M-SheheerMasood/kalos-dex/scad/renders/case_back_open.png

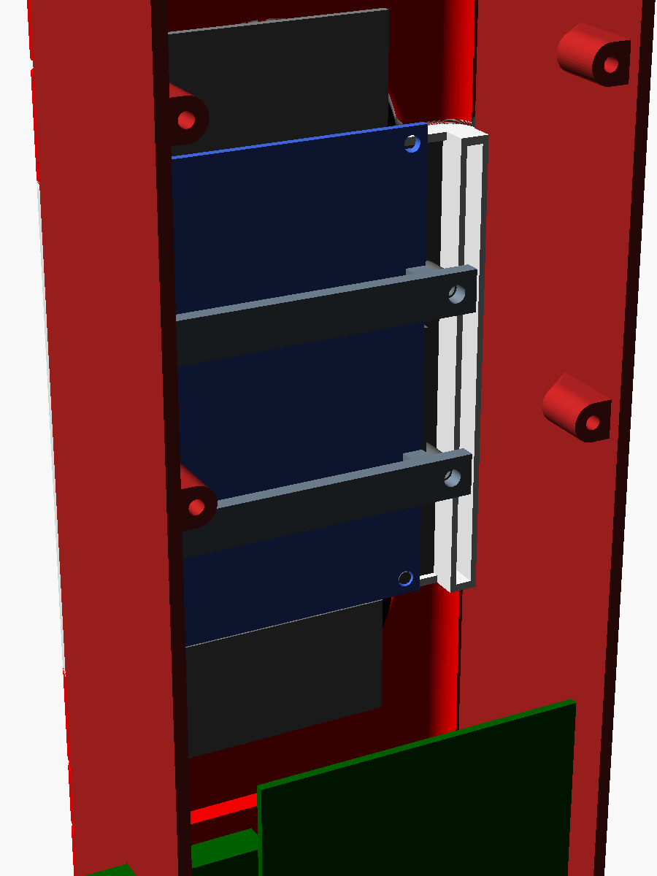
scad/renders/case_back_open.png
