M-SheheerMasood/kalos-dex/scad/renders/case_cutaway.png

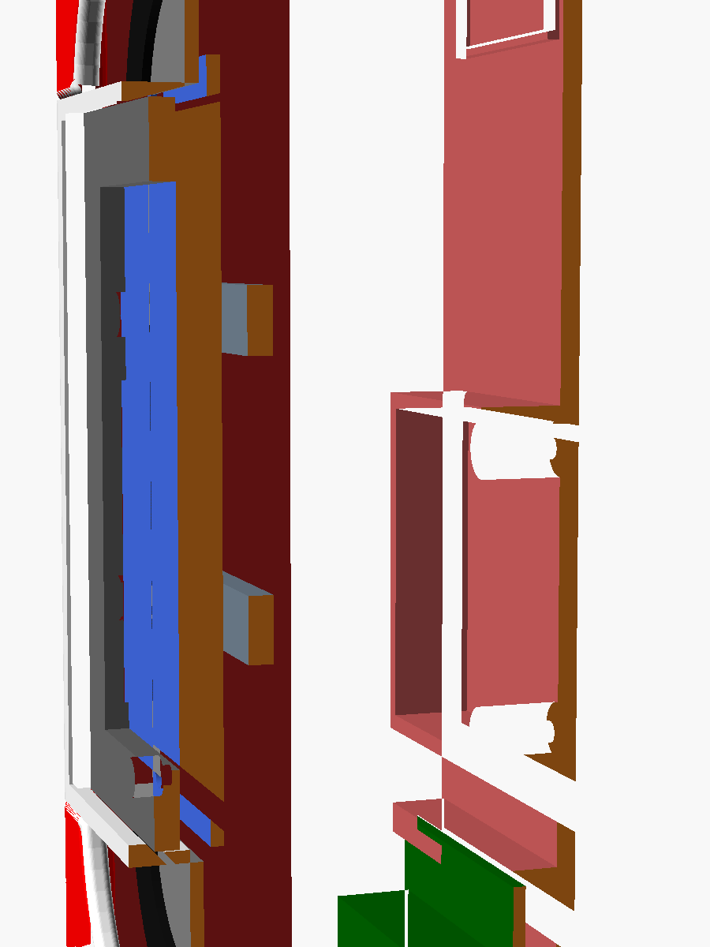
scad/renders/case_cutaway.png
