M-SheheerMasood/kalos-dex/scad/renders/case_front.png

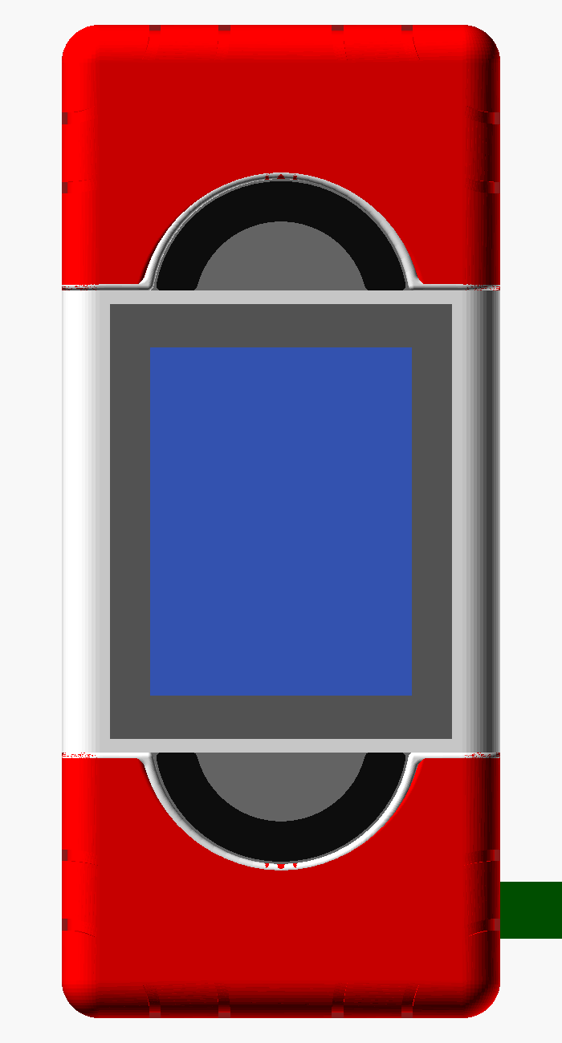
scad/renders/case_front.png
