M-SheheerMasood/kalos-dex/scad/renders/case_front_angle.png

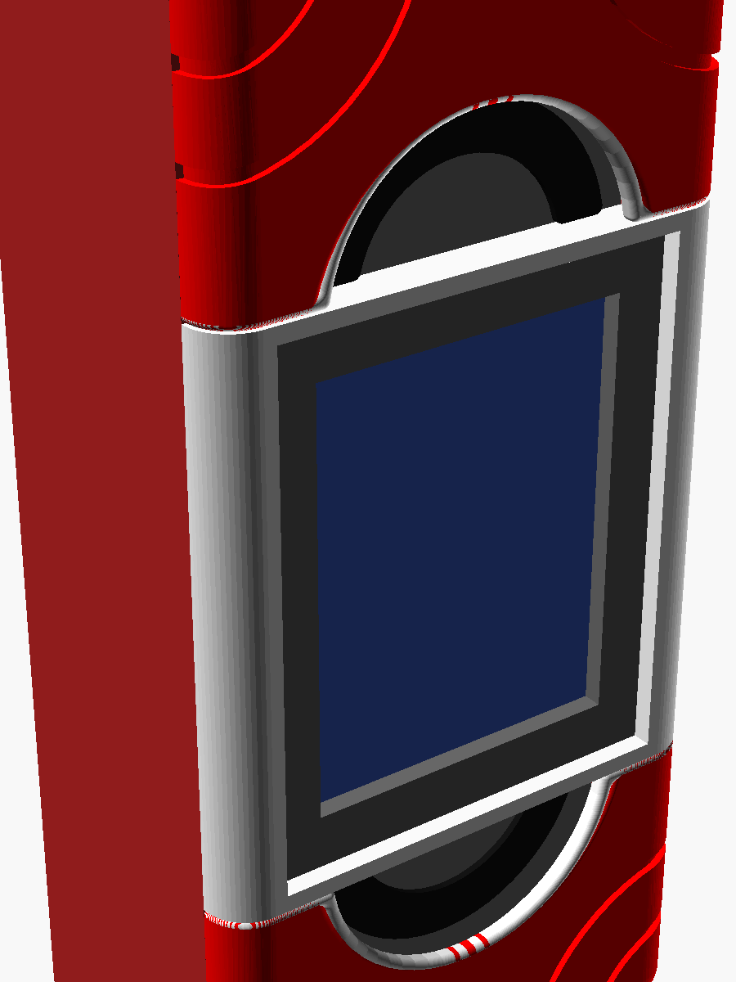
scad/renders/case_front_angle.png
