M-SheheerMasood/kalos-dex/scad/stl/main/any_knob.stl

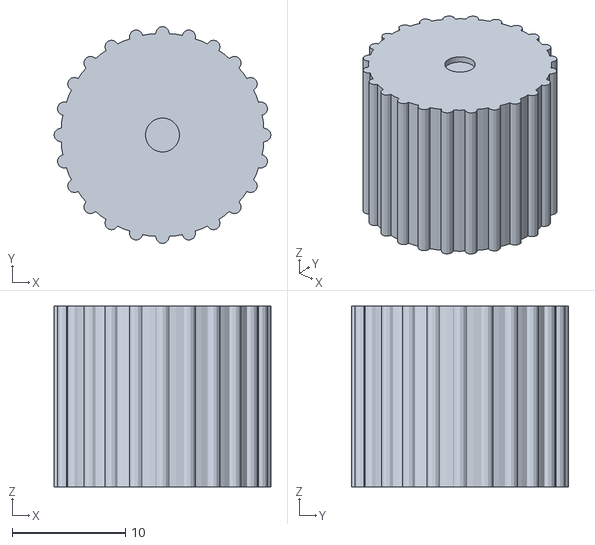
[picture p12: CAD file, 2026-10-22]
scad/stl/main/any_knob.stl
19.2 x 19.2 x 16.0
