M-SheheerMasood/kalos-dex/scad/stl/main/red_back_lid.stl

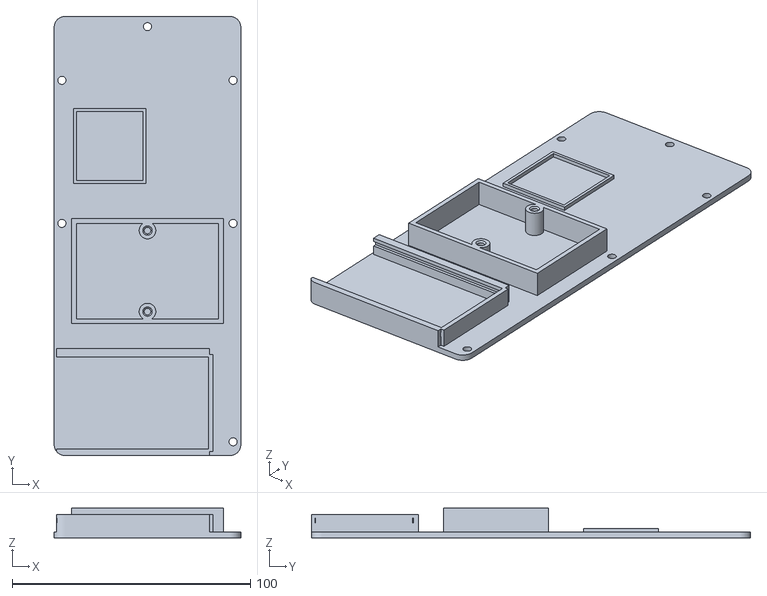
[picture p13: CAD file, 2026-10-22]
scad/stl/main/red_back_lid.stl
78.3 x 184.1 x 12.4
