M-SheheerMasood/kalos-dex/scad/stl/main/any_button_cap_x4.stl

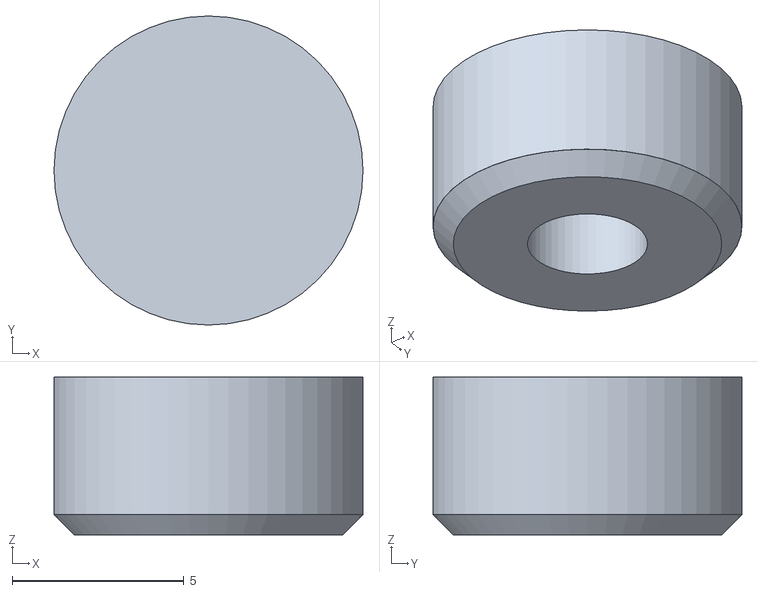
[picture p14: CAD file, 2026-10-22]
scad/stl/main/any_button_cap_x4.stl
9.00 x 9.00 x 4.60
