M-SheheerMasood/kalos-dex/scad/stl/main/white_screen_ring.stl

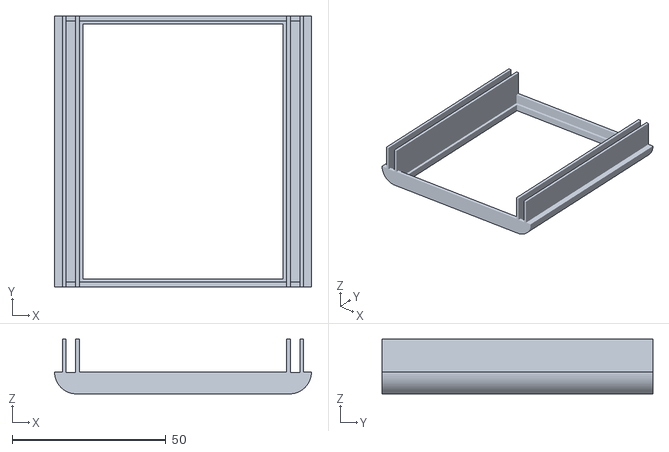
[picture p15: CAD file, 2026-10-22]
scad/stl/main/white_screen_ring.stl
83.6 x 88.0 x 17.9
