M-SheheerMasood/kalos-dex/scad/stl/main/grey_screen_face.stl

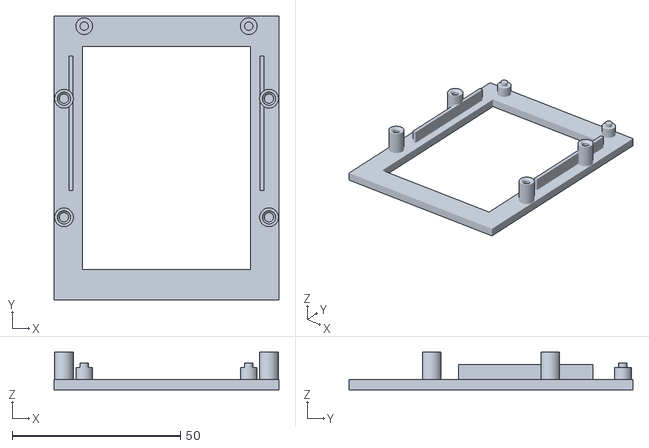
[picture p16: CAD file, 2026-10-22]
scad/stl/main/grey_screen_face.stl
66.9 x 84.5 x 11.2
