M-SheheerMasood/kalos-dex/scad/stl/main/red_tub.stl

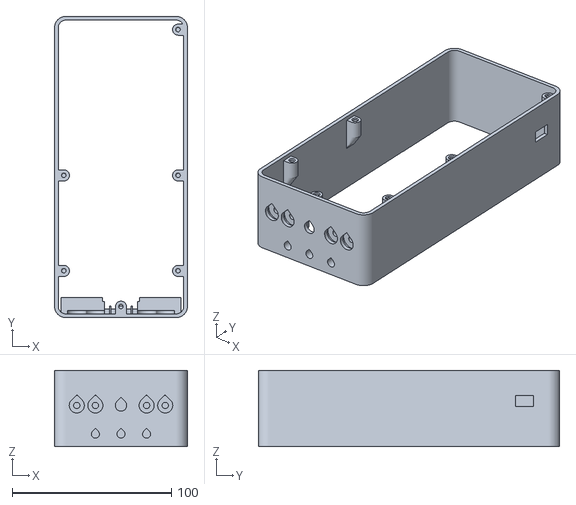
[picture p17: CAD file, 2026-10-22]
scad/stl/main/red_tub.stl
83.6 x 189.4 x 47.9
