M-SheheerMasood/kalos-dex/scad/stl/main/any_switch_retainer_x2.stl

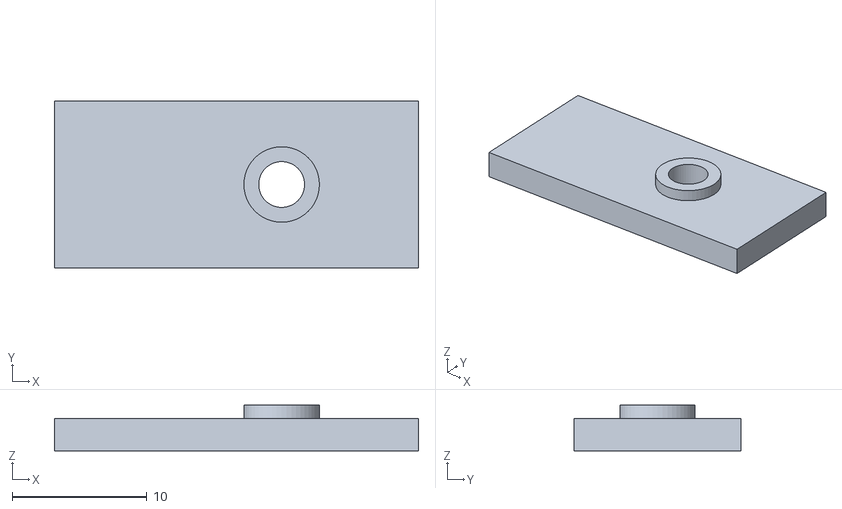
[picture p18: CAD file, 2026-10-22]
scad/stl/main/any_switch_retainer_x2.stl
27.0 x 12.4 x 3.40
