M-SheheerMasood/kalos-dex/scad/stl/main/any_weight_cover.stl

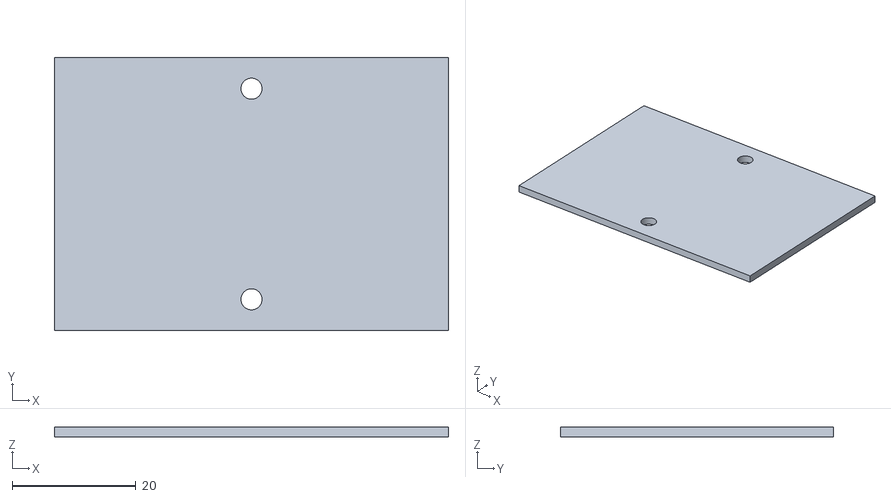
[picture p19: CAD file, 2026-10-22]
scad/stl/main/any_weight_cover.stl
63.6 x 44.0 x 1.60
