M-SheheerMasood/kalos-dex/scad/stl/main/any_display_clamp_x2.stl

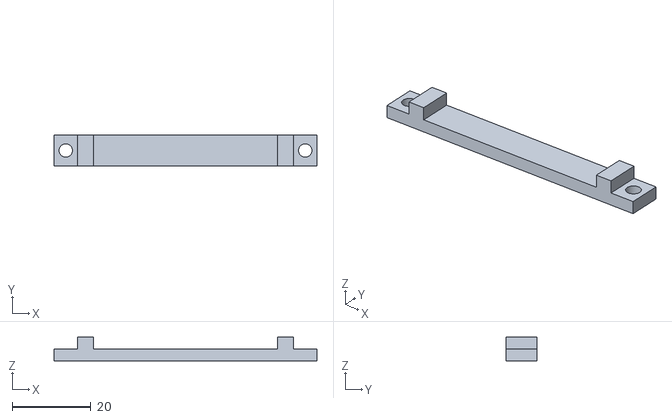
[picture p20: CAD file, 2026-10-22]
scad/stl/main/any_display_clamp_x2.stl
67.0 x 8.00 x 6.00
