M-SheheerMasood/kalos-dex/scad/stl/main/grey_arch_fill_x2.stl

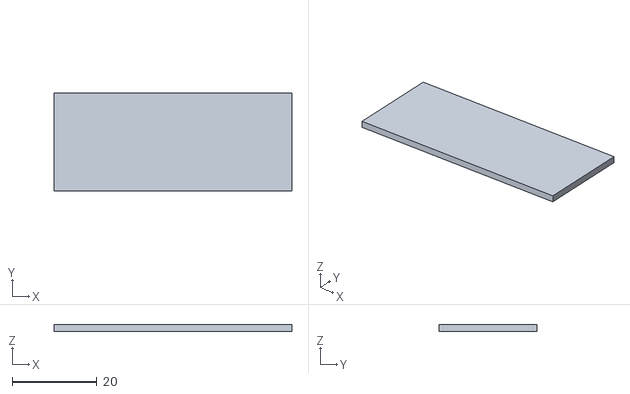
[picture p21: CAD file, 2026-10-22]
scad/stl/main/grey_arch_fill_x2.stl
56.0 x 23.0 x 1.60
