M-SheheerMasood/kalos-dex/firmware/kalos-dex/src/pet.h

// The virtual pet (F6): food / fun / energy (0..100), XP + levels, evolves, sleeps at night, keeps living
// while switched off (capped catch-up from the RTC), never dies. Owns the mood glow + the red status LED.
// Saved with storage's A/B + CRC records: every 3 min and 3 s after each feed / play.
#pragma once
#include <Arduino.h>

namespace pet {
enum class Mood : uint8_t { Egg, Sleeping, Hungry, Tired, Sad, Happy, Okay, Angry };   // add new ones at the end
enum class Result : uint8_t { Ok, Full, TooTired, Egg, Angry };

void begin();                  // after storage + timekeeper: load, catch up on the time switched off
void update(uint32_t now);     // call every loop

Result feed();
Result play();
void wake();                   // any button at night: awake for PET_WAKE_MS

Mood mood();
const char *moodName(Mood m);
bool hatched();
uint8_t stage();               // 0 = egg, 1..3
const char *name();            // species name of the current stage ("Egg" before hatching)
bool shiny();
bool asleep();
float food(), fun(), energy();
uint8_t level();
uint32_t xp(), xpNeeded();     // XP inside the current level / needed for the next
uint32_t eggSecondsLeft();      // until the egg is ready (0 = ready or hatched)
bool eggReady();               // egg whose time is up: waits for the user to hatch it
const char *message();         // last thing that happened ("Yum!", "I'm full!", ...) – "" when none
uint32_t messageAt();          // millis() of that message
uint32_t version();            // goes up whenever anything shown on screen changes
// "together" data (Dex entry screen)
uint32_t togetherS();          // seconds switched on together, egg included
uint32_t metUtc();             // when the egg arrived (0 = unknown)
uint32_t hatchedUtc();         // 0 = not hatched / unknown
uint32_t feeds(), plays();
uint16_t nights();             // nights slept
uint8_t nextEvolveLevel();     // 0 = final form (or egg)

void holdGlow(bool hold);      // test screens borrow the strip + status LEDs; false = give them back
void showGlow(Mood m);         // hwtest: show this mood's glow (use with holdGlow(true))
void reset();                  // new egg (Settings later: hold Feed + Play 3 s)
void printStatus();            // serial "PET"

// Debug mode (Settings page 2, user 2026-10-29): on = the pet becomes a TEST copy (cheats change only the copy, nothing
// is saved); off = the real pet is loaded again from its save, catching up the time. Always off after a restart.
void setTestMode(bool on);
bool testMode();
bool canEvolve();                     // its level allows the next form: "!" on Home, hold Feed + Play
void evolveNow();                     // the user confirmed: next form (the show is Home's)
bool evolveReadyNow();                // Debug: level = the next form's level (false: none / already)
void eggReadyNow();                   // egg: time's up (hatch it on Home to see the show)
void levelUp();                       // +1 level
void calmDown();                      // counts as cared for just now (no longer angry)

// testing (Debug screen + serial commands in the hwtest build)
void skipMinutes(uint32_t minutes);   // pretend it was switched off this long (same catch-up as at boot)
void addXp(uint32_t n);
void hatchNow();
void setCareHoursAgo(uint32_t hours);   // last accepted feed / play that long ago (24+ = angry)
void setStage(uint8_t stage);       // 1..3, no evolution animation
void setShiny(bool on);
void setStat(char which, float v);    // 'f' food, 'u' fun, 'e' energy
}  // namespace pet
