M-SheheerMasood/kalos-dex/(commit log)

2026-10-22 Kalos Dex: ESP32 desk gadget – firmware v0.6.0, case, tools and docs
    [any_button_cap_x4.stl, any_display_clamp_x2.stl, any_knob.stl, any_switch_retainer_x2.stl, any_weight_cover.stl, caps.scad, grey_arch_fill_x2.stl, grey_screen_face.stl]
2026-10-27 v0.7.0: pet sprites support (placeholder in this repo), reactions, mood bubbles, rounder UI, enforced agent workflow
    - Firmware 0.7.0: one Pokemon line per build (sprite data generated locally, not included - the build uses a placeholder pet), feed/play/refusal reactions, mood bubbles, angry mood, pet save v2, display VCOM for the TN panel, Nunito smooth font + HP-style bars, taller title bar.
    - docs/agent-workflow.md + agent-harness/: the hooks and step tool that enforce how the AI agent works on this project, the design decisions behind them, what changed in real use, and one worked task.
    - Renders of the current Settings and Home screens, the mood bubble designs, updated README, AGENTS.md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
2026-10-27 docs: fixes before publishing - placeholders instead of full paths in the harness copy, test count, PLAN notes, add tools/fake_companion.py
    [fake_companion.py]
2026-10-31 v0.8.0: hatching and evolving (each with its own scene, only when the owner holds two buttons), Dex base stats page, debug mode with a throwaway test pet, pet balance; docs and renders updated
